EKlatt/AAA-Tester/Artikel Fotos/Bild 6 Revolver und Falle ....jpg

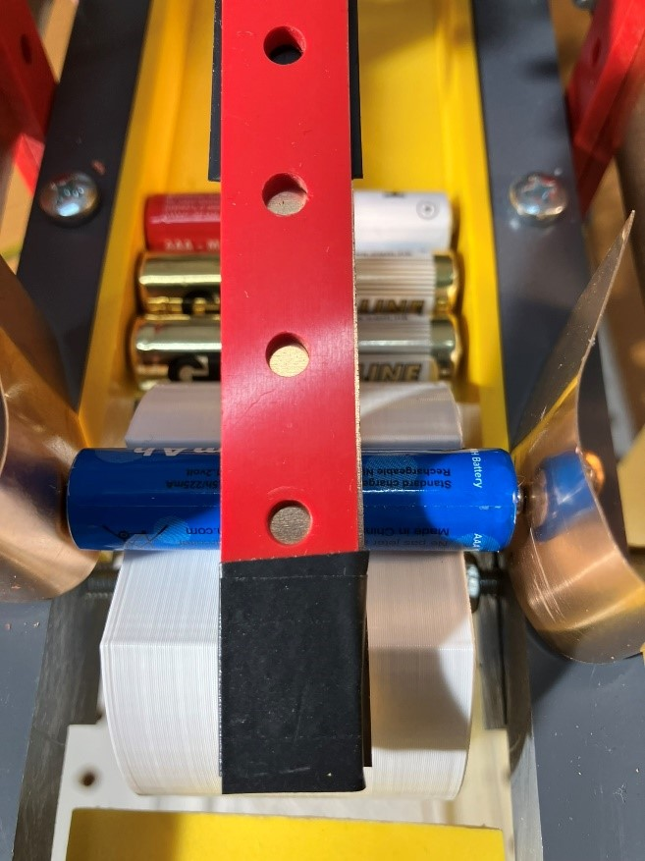
Artikel Fotos/Bild 6 Revolver und Falle ....jpg
