EKlatt/AAA-Tester/Artikel Fotos/Bild 7 Sortiereinrichtung ....jpg.JPEG

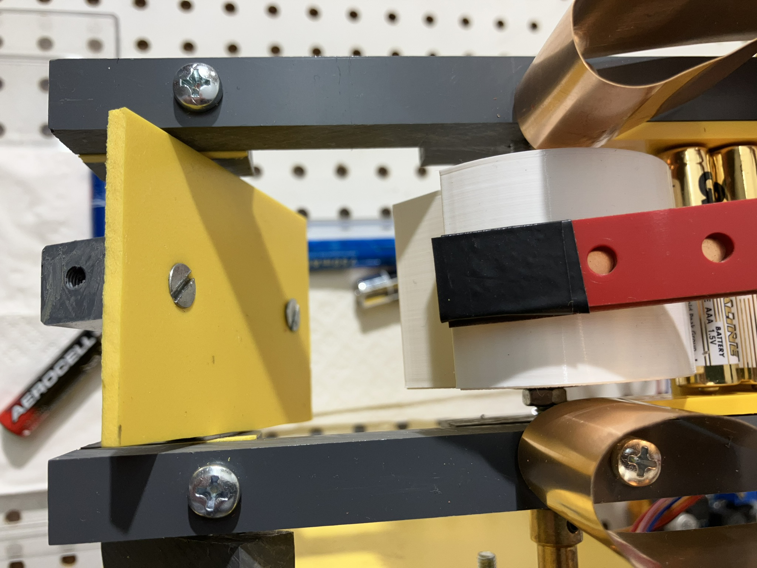
Artikel Fotos/Bild 7 Sortiereinrichtung ....jpg.JPEG
