EKlatt/AAA-Tester/Artikel Fotos/Bild 2 Prüfanlage Übersicht.jpg

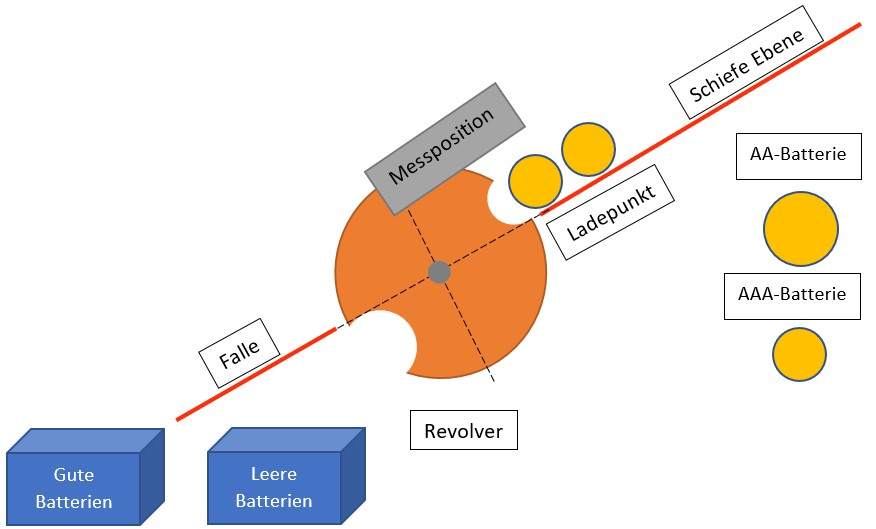
Artikel Fotos/Bild 2 Prüfanlage Übersicht.jpg
