EKlatt/AAA-Tester/Artikel Fotos/Bild 3 Servo- und Schrittmotor.jpg

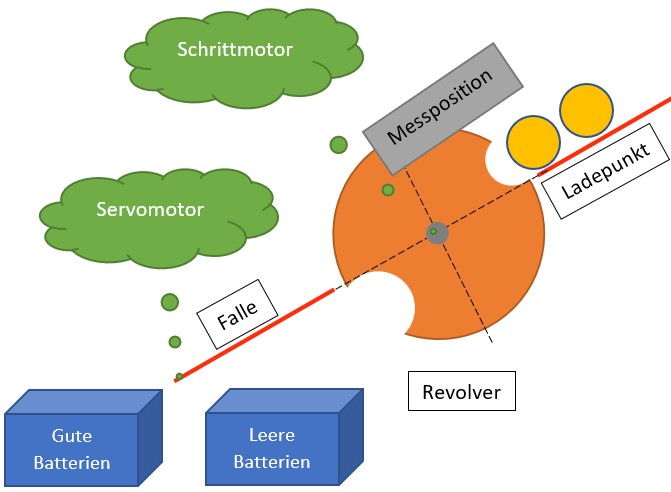
Artikel Fotos/Bild 3 Servo- und Schrittmotor.jpg
