EKlatt/AAA-Tester/Artikel Fotos/Bild 4 Blick auf die gesamte Prüf.....JPEG

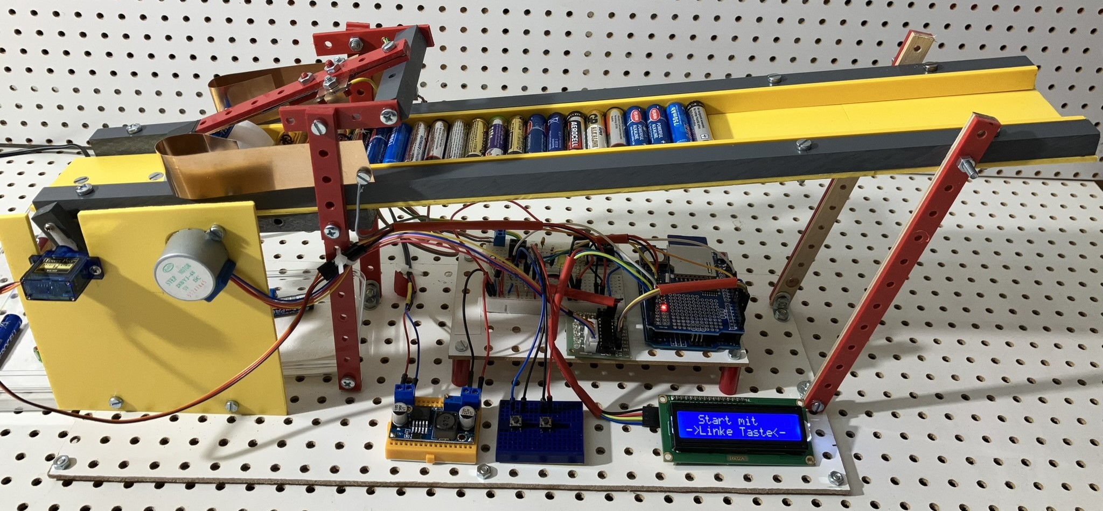
Artikel Fotos/Bild 4 Blick auf die gesamte Prüf.....JPEG
