EKlatt/AAA-Tester/Artikel Fotos/Bild 5a Maße des Revolvers ....jpg

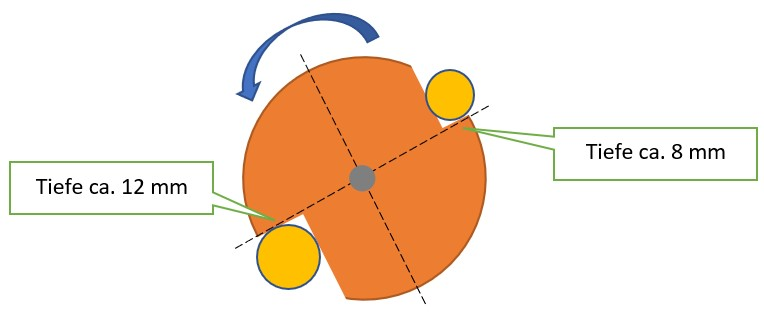
Artikel Fotos/Bild 5a Maße des Revolvers ....jpg
