EKlatt/AAA-Tester/Artikel Fotos/Bild 5b Maße des Revolvers ....png

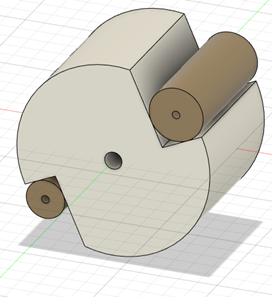
Artikel Fotos/Bild 5b Maße des Revolvers ....png
