EKlatt/AAA-Tester/Artikel Fotos/Bild 11 Messpositon.jpg

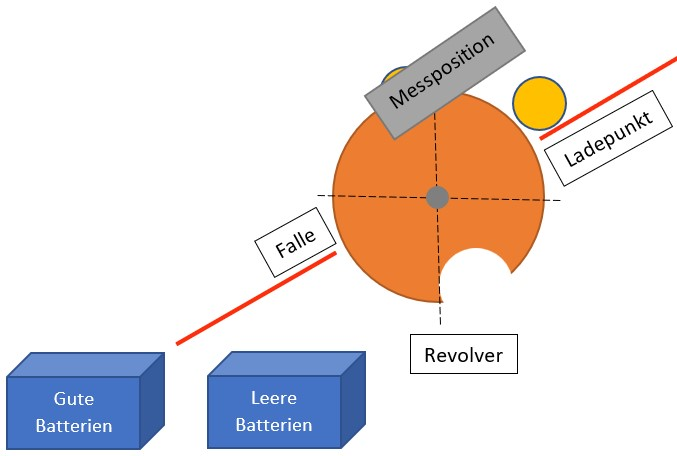
Artikel Fotos/Bild 11 Messpositon.jpg
