EKlatt/AAA-Tester/Artikel Fotos/Bild 12 Schaltbild der Gebraucht....jpg

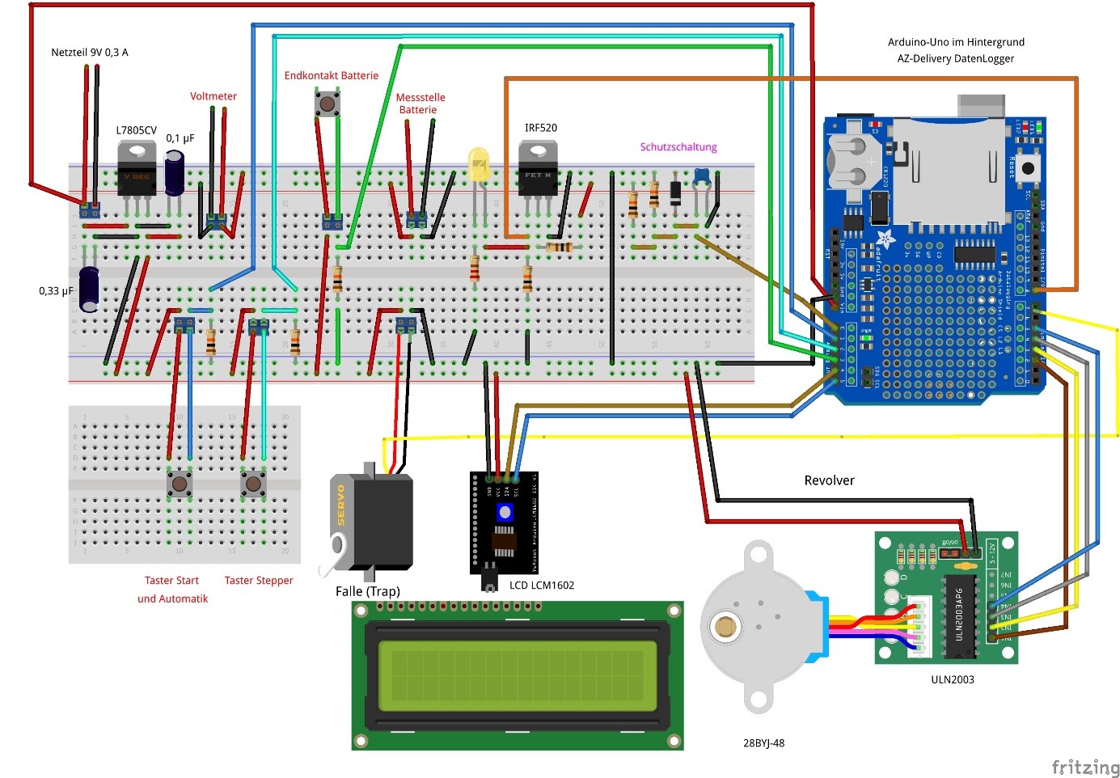
Artikel Fotos/Bild 12 Schaltbild der Gebraucht....jpg
