EKlatt/AAA-Tester/Artikel Fotos/Bild 13 Spannungsteiler....jpg

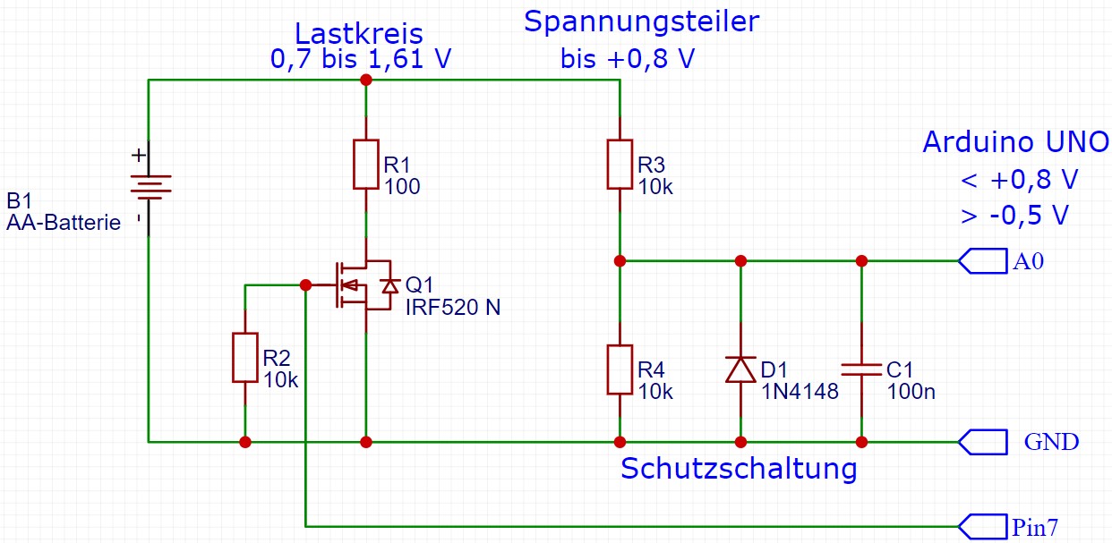
Artikel Fotos/Bild 13 Spannungsteiler....jpg
