EKlatt/AAA-Tester/Artikel Fotos/Bild 14 Arduino-IDE.jpg

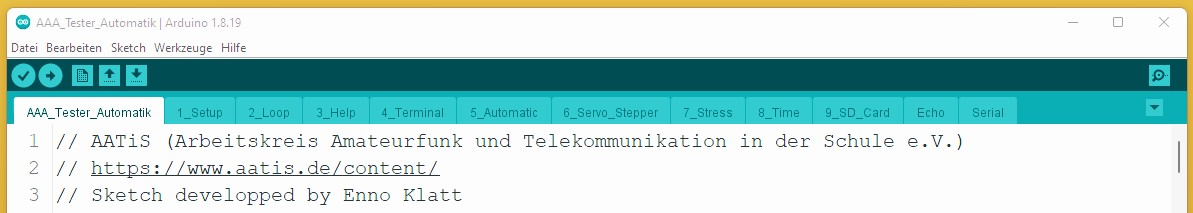
Artikel Fotos/Bild 14 Arduino-IDE.jpg
