EKlatt/AAA-Tester/Artikel Fotos/Tabelle 1. Prüfvorrichtung anpassen.jpg

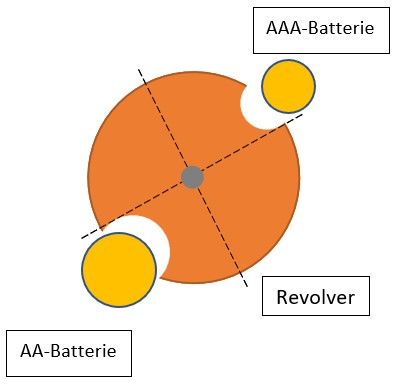
Artikel Fotos/Tabelle 1. Prüfvorrichtung anpassen.jpg
