EKlatt/AAA-Tester/Artikel Fotos/Tabelle 2. Batterie laden.jpg

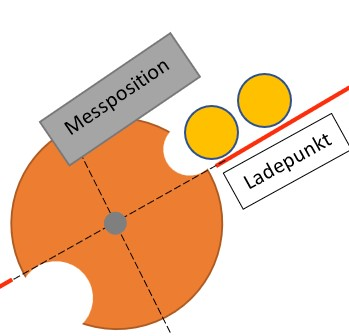
Artikel Fotos/Tabelle 2. Batterie laden.jpg
