EKlatt/AAA-Tester/Artikel Fotos/Tabelle 3. Ladepunkt Messposition.jpg

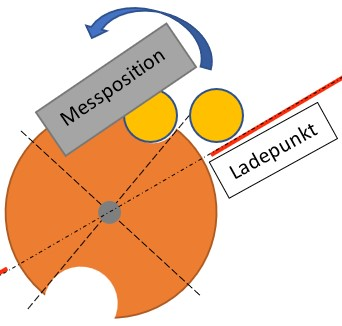
Artikel Fotos/Tabelle 3. Ladepunkt Messposition.jpg
