EKlatt/AAA-Tester/Artikel Fotos/Tabelle 4. 5.. Batterie vorhanden.jpg

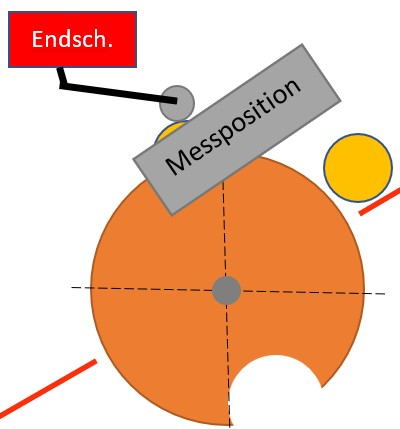
Artikel Fotos/Tabelle 4. 5.. Batterie vorhanden.jpg
