EKlatt/AAA-Tester/Artikel Fotos/Tabelle 6. 7. 8. 9. 10. Messposition.jpg

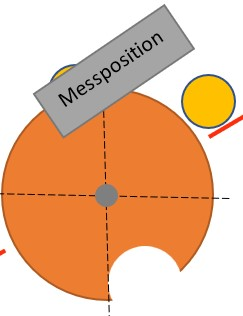
Artikel Fotos/Tabelle 6. 7. 8. 9. 10. Messposition.jpg
