EKlatt/AAA-Tester/Artikel Fotos/Tabelle 11. Messposition Falle.jpg

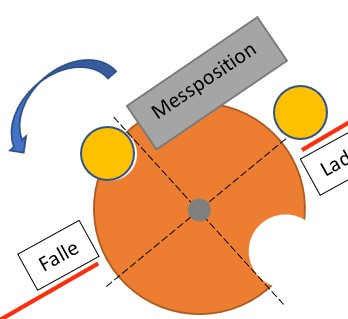
Artikel Fotos/Tabelle 11. Messposition Falle.jpg
