EKlatt/AAA-Tester/Artikel Fotos/Tabelle 12. Gute Batterie.jpg

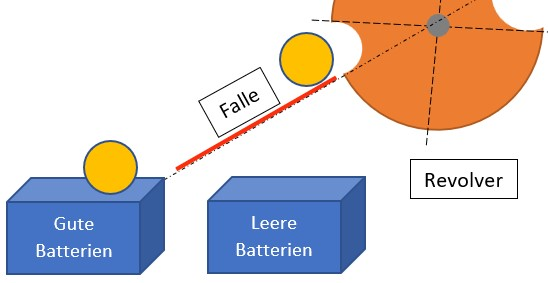
Artikel Fotos/Tabelle 12. Gute Batterie.jpg
