EKlatt/AAA-Tester/Artikel Fotos/Tabelle 13. Leere Batterie.jpg

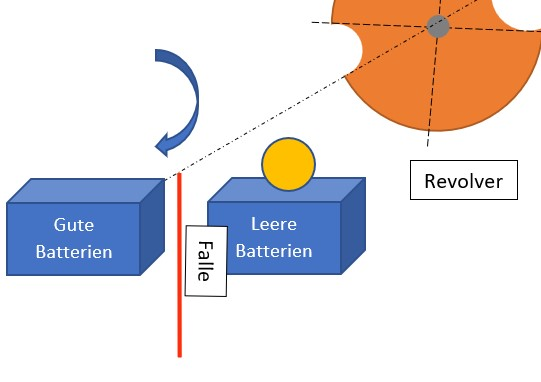
Artikel Fotos/Tabelle 13. Leere Batterie.jpg
