EKlatt/AAA-Tester/Artikel Fotos/Tabelle 14. Ladepunkt.jpg

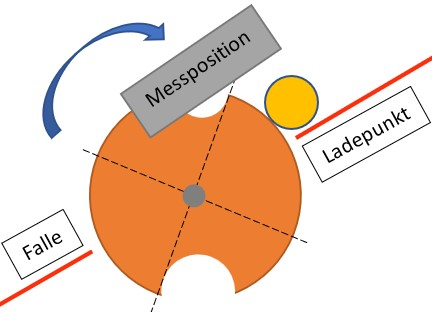
Artikel Fotos/Tabelle 14. Ladepunkt.jpg
