EKlatt/AAA-Tester/3D/AAA-Revolver v7.dxf

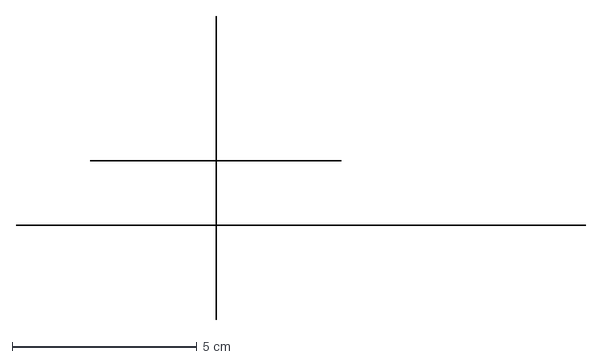
[picture p21: CAD file, 2023-01-27]
3D/AAA-Revolver v7.dxf
15.4 x 8.20 cm
