EKlatt/AAA-Tester/3D/Revolver.stl

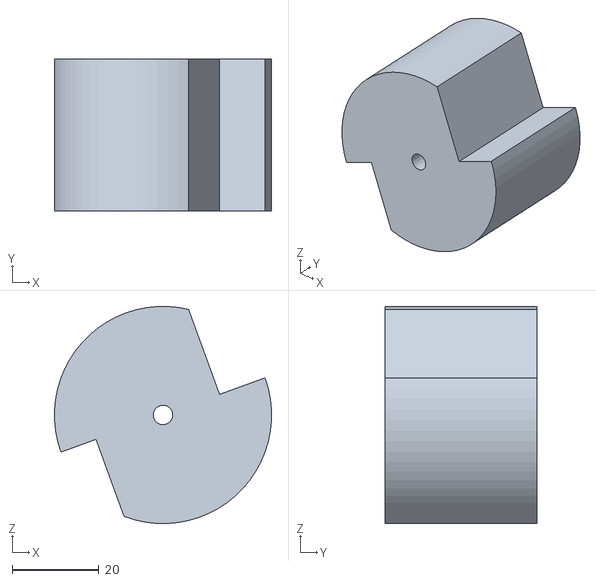
[picture p22: CAD file, 2023-01-27]
3D/Revolver.stl
49.9 x 35.0 x 50.0
