EKlatt/AAA-Tester/(list of files, cad)

Other CAD files:
3D/AAA-Revolver.f3d
