EKlatt/AAA-Tester/(commit log)

2022-11-11 Create Bild 10 Anpassung der Prüfvorrichtung.jpg
2022-11-11 Create Bild 12 Schaltbild der Gebraucht....jpg
2022-11-11 Create Bild 14 Arduino-IDE.jpg
2022-11-11 Create Bild 3 Servo- und Schrittmotor.jpg
2022-11-11 Create Bild 4 Blick auf die gesamte Prüf.....JPEG
2022-11-11 Create Bild 5a Maße des Revolvers ....jpg
2022-11-11 Create Bild 5b Maße des Revolvers ....png
2022-11-11 Create Bild 6 Revolver und Falle ....jpg
2023-01-27 Create AAA-Revolver v7.dxf
    [AAA-Revolver v7.dxf]
